pdxalz/AnnieM/(threads)

Thread 6 (2023-08-28):

Gusts and Lulls

pdxalz, 2023-08-28:
Annie should keep track of gusts and lulls along with current wind speed.

pdxalz, 2023-12-30:
Now tracks average wind gusts and lulls every minute over a 10 minute period

Closed 2023-12-30.

Thread 7 (2023-08-28):

New remote commands

pdxalz, 2023-08-28:
Remotely be able:

1. Reset
2. Request the current wind status
3. Change the MQTT broker.

Closed 2024-05-22.
