pdxalz/AnnieM/pcb/AnnieM.kicad_pcb

## KiCad design pcb/AnnieM.kicad_pcb (2023-12-28)

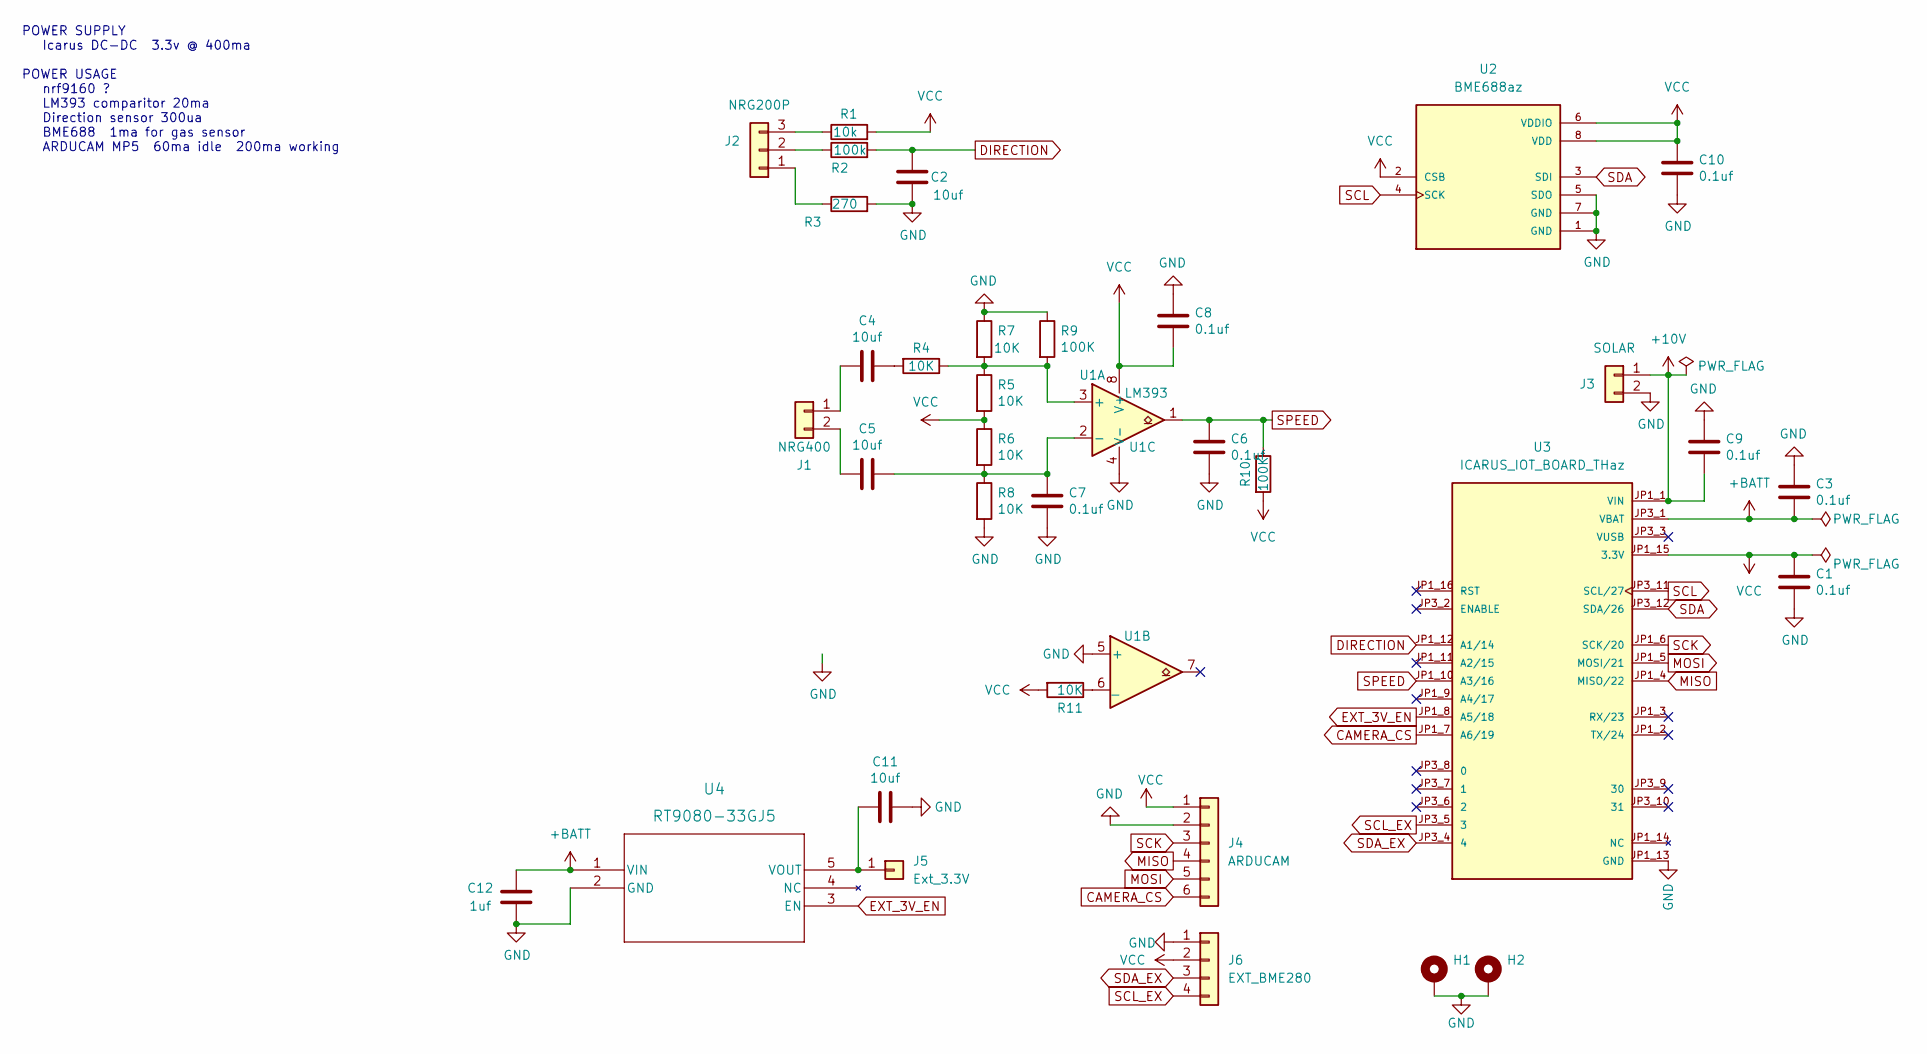
[picture p1: schematic AnnieM.kicad_sch]

Parts:
C1, C3, C6, C7, C8, C9, C10: 0.1uf; C_0603_1608Metric
C2, C4, C5, C11: 10uf; C_0805_2012Metric
C12: 1uf; C_0805_2012Metric
H1, H2: MountingHole_2.2mm_M2_DIN965_Pad
J1: NRG400; TerminalBlock_RND_205-00232_1x02_P5.08mm_Horizontal
J2: NRG200P; TerminalBlock_RND_205-00233_1x03_P5.08mm_Horizontal
J3: SOLAR; JST_XA_B02B-XASK-1_1x02_P2.50mm_Vertical
J4: ARDUCAM; PinHeader_1x06_P2.54mm_Vertical
J5: Ext_3.3V; PinSocket_1x01_P2.54mm_Vertical
J6: EXT_BME280; PinSocket_1x04_P2.54mm_Vertical
R1: 10k; R_0603_1608Metric
R2: 100k; R_0603_1608Metric
R3: 270; R_0603_1608Metric
R4, R5, R6, R7, R8, R11: 10K; R_0603_1608Metric
R9, R10: 100K; R_0603_1608Metric
U1: LM393; DIP-8_W7.62mm_LongPads
U2: BME688az; IC_BME688; PARTREV 1.0
U3: ICARUS_IOT_BOARD_THaz; MODULE_ICARUS_IOT_BOARD_THaz; PARTREV January 20, 2020
U4: RT9080-33GJ5; TSOT-23-5

Connections:
+10V: C9.1, J3.1, U3.JP1_1 (VIN)
+BATT: C3.1, C12.1, U3.JP3_1 (VBAT), U4.1 (VIN)
CAMERA_CS: J4.6, U3.JP1_7 (A6/19)
DIRECTION: C2.2, R2.2, U3.JP1_12 (A1/14)
EXT_3V_EN: U3.JP1_8 (A5/18), U4.3 (EN)
GND: C1.1, C2.1, C3.2, C6.1, C7.1, C8.2, C9.2, C10.1, C11.1, C12.2, H1.1, H2.1, J3.2, J4.2, J6.1, R3.2, R7.1, R8.2, R9.1, U1.4 (V-), U1.5 (+), U2.1 (GND), U2.5 (SDO), U2.7 (GND), U3.JP1_13 (GND), U4.2 (GND)
MISO: J4.4, U3.JP1_4 (MISO/22)
MOSI: J4.5, U3.JP1_5 (MOSI/21)
unnamed: C4.1, R4.2
unnamed: C4.2, J1.1
unnamed: C5.1, C7.2, R6.2, R8.1, U1.2 (-)
unnamed: C5.2, J1.2
unnamed: C11.2, J5.1, U4.5 (VOUT)
unnamed: J2.1, R3.1
unnamed: J2.2, R2.1
unnamed: J2.3, R1.1
unnamed: R4.1, R5.1, R7.2, R9.2, U1.3 (+)
unnamed: R11.1, U1.6 (_)
SCK: J4.3, U3.JP1_6 (SCK/20)
SCL: U2.4 (SCK), U3.JP3_11 (SCL/27)
SCL_EX: J6.4, U3.JP3_5 (3)
SDA: U2.3 (SDI), U3.JP3_12 (SDA/26)
SDA_EX: J6.3, U3.JP3_4 (4)
SPEED: C6.2, R10.1, U1.1, U3.JP1_10 (A3/16)
VCC: C1.2, C8.1, C10.2, J4.1, J6.2, R1.2, R5.2, R6.1, R10.2, R11.2, U1.8 (V+), U2.2 (CSB), U2.6 (VDDIO), U2.8 (VDD), U3.JP1_15 (3.3V)

Notes on the sheet:
POWER SUPPLY Icarus DC-DC 3.3v @ 400ma POWER USAGE nrf9160 ? LM393 comparitor 20ma Direction sensor 300ua BME688 1ma for gas sensor ARDUCAM MP5 60ma idle 200ma working

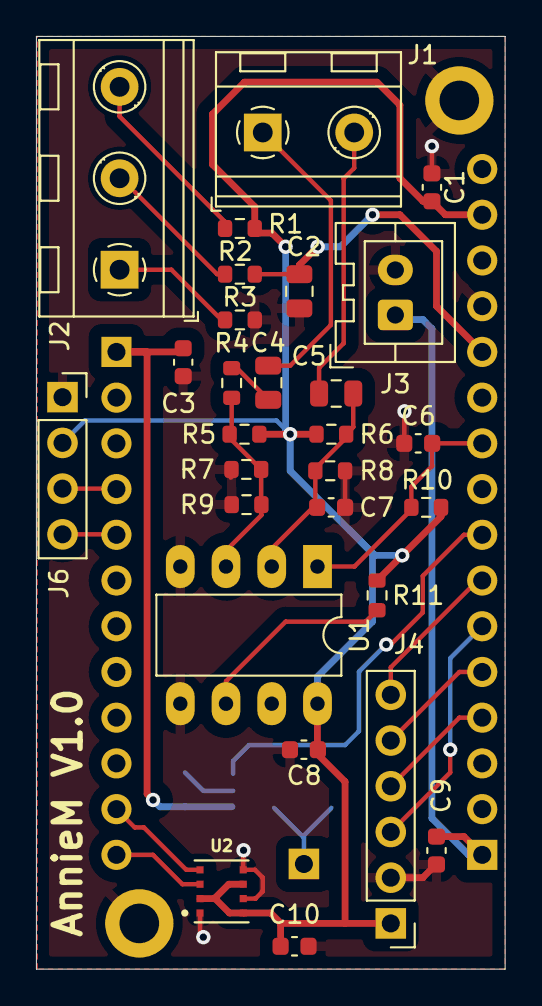
[picture p2: board AnnieM.kicad_pcb from above]

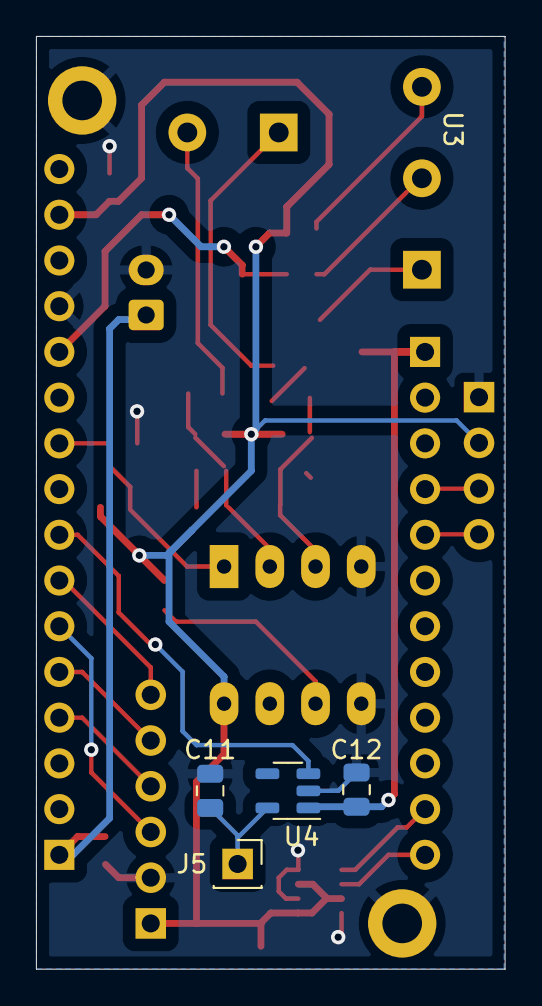
[picture p3: board AnnieM.kicad_pcb from below]

Board: 2 copper layers, 26.0 x 51.8 mm, 35 parts (5 on the bottom side), 25 nets.
