pdxalz/AnnieM/src/wind_sensor.c

#include <stdio.h>
#include <zephyr/kernel.h>
#include <zephyr/net/socket.h>
#include <modem/lte_lc.h>
#include <zephyr/drivers/gpio.h>
#include <date_time.h>

#include <zephyr/net/mqtt.h>

#include "mqtt_connection.h"
#include "wind_sensor.h"
#include "adc.h"
#include "health.h"
#include "leds.h"
#include "cameraThread.h"
#include "watchdog.h"

#include <zephyr/logging/log.h>
LOG_MODULE_REGISTER(sensor, LOG_LEVEL_INF);

#define SECONDS_PER_SAMPLE (60) // 60 is the minimum, lower requires code fix
#define SAMPLE_DURATION 6
#define REPORTS_PER_HOUR 6 // 6 is every 10 minutes
#define MINUTES_PER_REPORT (60 / REPORTS_PER_HOUR)

#define WIND_SPEED_NODE DT_ALIAS(windspeed0)
static const struct gpio_dt_spec windspeed = GPIO_DT_SPEC_GET(WIND_SPEED_NODE, gpios);

#define WIND_SCALE (102.0 / 60.0)
#define MAX_DIRECTION_VOLTAGE 1650
//#define NORTH_OFFSET 90 // Aim to the east so discontinuity is not at north
#define NORTH_OFFSET 115 // Should capture the kite beach

static volatile int frequency = 0;
static volatile int64_t lasttime = 0;

static int sample_count;
static int speed;
static int gust;
static int lull;

static uint16_t wind_direction;

// circular buffer holding direction voltages
uint16_t _dir_buf[8]; // fixed size due to averaging calculation
uint16_t _dir_idx = 0;

static struct gpio_callback windspeed_cb_data;

static void sensor_sample_timer_cb(struct k_timer *work);
static void wind_direction_timer_cb(struct k_timer *work);
static void wind_speed_sample_timer_cb(struct k_timer *work);
static void publish_reports_work_cb(struct k_work *timer_id);

static uint16_t circ_avg(uint16_t a, uint16_t b);

//************************
// Timers and Work threads
//************************
static K_TIMER_DEFINE(sensor_sample_timer, sensor_sample_timer_cb, NULL);
static K_TIMER_DEFINE(wind_direction_timer, wind_direction_timer_cb, NULL);
static K_TIMER_DEFINE(wind_speed_sample_timer, wind_speed_sample_timer_cb, NULL);
static K_WORK_DEFINE(publish_reports_work, publish_reports_work_cb);

// initiates the measuring of wind data
static void sensor_sample_timer_cb(struct k_timer *work)
{
	turn_leds_on_with_color(GREEN);

	// start counting windspeed pulses
	frequency = 0;
	k_timer_start(&wind_speed_sample_timer, K_SECONDS(SAMPLE_DURATION), K_FOREVER);

	// start sampling direction sensor
	k_timer_start(&wind_direction_timer, K_SECONDS(1), K_MSEC(400));
}

// updates the wind_direction variable by reading sensor voltage and applying a running average.
// runs multiple times while windspeed is being calculated
static void wind_direction_timer_cb(struct k_timer *work)
{
	uint16_t voltage;

	if (get_adc_voltage(ADC_WIND_DIR_ID, &voltage) != 0)
	{
		LOG_WRN("Failed to get direction voltage\n");
		return;
	};

	//	printk("direction voltage, %d\n", voltage);
	_dir_buf[_dir_idx] = (((uint32_t)voltage * 360) / MAX_DIRECTION_VOLTAGE + NORTH_OFFSET) % 360;

	_dir_idx = (_dir_idx + 1) % 8;
	wind_direction = circ_avg(
		circ_avg(circ_avg(_dir_buf[0], _dir_buf[1]), circ_avg(_dir_buf[2], _dir_buf[3])),
		circ_avg(circ_avg(_dir_buf[4], _dir_buf[5]), circ_avg(_dir_buf[6], _dir_buf[7])));

	//	LOG_INF("dir volts %d  dir %d\n", voltage, wind_direction);
}

// The timer sets the period wind speed pulses are counted. At the end of the timer
// all sensor data gathering (speed and direction) is complete and then
// the wind speed is calculated from the number of pulses counted.
// A job is submitted to send the MQTT data
static void wind_speed_sample_timer_cb(struct k_timer *work)
{
	float f = frequency / 6.0 * WIND_SCALE + 0.5;
	int current_speed = (int)f;
	++sample_count;
	speed += current_speed;
	gust = (gust > current_speed) ? gust : current_speed;
	lull = (lull < current_speed) ? lull : current_speed;

	LOG_DBG("Windspeed a=%d  g=%d  l=%d\n", current_speed, gust, lull);
	frequency = 0;

	k_work_submit(&publish_reports_work);
}

// ISR called on each pulse from the speed sensor, counts the number of pulses in
// the timer period
void windspeed_handler(const struct device *dev, struct gpio_callback *cb, uint32_t pins)
{
	int64_t time = k_uptime_get();
	// filter out sensor glitches
	if ((time - lasttime) > 10)
	{
		frequency++;
	}
	lasttime = time;
}

// background task that sends the MQTT sensor data
// data is sent less often if night time or little wind
static void publish_reports_work_cb(struct k_work *timer_id)
{
	time_t now;
	now = time(NULL);
	struct tm tm;
	gmtime_r(&now, &tm);
	int avg_speed;
	// printk("publish_reports_work_cb\n");
	int minute = tm.tm_min;

	// only report if it's the first sample period of the report period
	if (minute % MINUTES_PER_REPORT != 0)
	{
		turn_leds_on_with_color(BLUE);
		return;
	}

	turn_leds_on_with_color(MAGENTA);

	avg_speed = speed / sample_count;

	uint8_t *msgbuf = get_mqtt_message_buf();
	uint8_t *topicbuf = get_mqtt_topic_buf();

	sprintf(topicbuf, "%s/wind", CONFIG_MQTT_PRIMARY_TOPIC);
	k_timer_stop(&wind_direction_timer);

	sprintf(msgbuf, "{\"t\":\"%d/%d/%d %d:%0d\", \"d\":%d, \"a\":%d, \"g\":%d, \"l\":%d}",
			tm.tm_mon + 1, tm.tm_mday, tm.tm_year % 100, tm.tm_hour, tm.tm_min,
			wind_direction, avg_speed, gust, lull);


	// todo: necessary?  wait for photo to finish
	while (sending_photo())
	{
		turn_leds_on_with_color(WHITE);
		k_msleep(1000);
		printk("Waiting for photo to finish\n");
	}
	turn_leds_on_with_color(MAGENTA);

	int err;
	printk("Sending wind data\n");
	err = data_publish(MQTT_QOS_1_AT_LEAST_ONCE,
					   msgbuf, strlen(msgbuf), topicbuf, 0);
	printk("Wind data sent\n");
	lull = 100;
	gust = 0;
	speed = 0;
	sample_count = 0;

	if (err)
	{
		LOG_WRN("Failed to send message, %d\n", err);
		return;
	}
	watchdog_still_running();

	// update and report health data at the beginning of the hour
	printk("publishing health data. minute = %d\n", minute);
	if (minute < MINUTES_PER_REPORT)
	{
		k_msleep(1000);
		turn_leds_on_with_color(RED);
		publish_health_data();
	}
}

//************************
// Static functions
//************************

// averages two angles, result is between 0 and 359
static uint16_t circ_avg(uint16_t a, uint16_t b)
{
	int16_t diff = ((a - b + 180 + 360) % 360) - 180;
	int16_t angle = (360 + b + (diff / 2)) % 360;
	//	printk("avg=      %d, %d, %d, %d", a, b, diff, angle);
	return angle;
}

//************************
// Public functions
//************************

int init_wind_sensor()
{
	int err;
	if (!device_is_ready(windspeed.port))
	{
		return -1;
	}

	lull = 100;
	gust = 0;

	err = gpio_pin_configure_dt(&windspeed, GPIO_INPUT | GPIO_PULL_UP);
	if (err < 0)
	{
		return err;
	}
	err = gpio_pin_interrupt_configure_dt(&windspeed, GPIO_INT_EDGE_TO_ACTIVE);

	gpio_init_callback(&windspeed_cb_data, windspeed_handler, BIT(windspeed.pin));

	gpio_add_callback(windspeed.port, &windspeed_cb_data);

	k_timer_start(&sensor_sample_timer, K_SECONDS(5), K_SECONDS(SECONDS_PER_SAMPLE));

	return 0;
}
