pdxalz/AnnieM/src/adc.h

#ifndef _ADC_H_
#define _ADC_H_

// ADC Channel IDs
#define ADC_BATTERY_VOLTAGE_ID 0
#define ADC_WIND_DIR_ID 1
#define ADC_TEMPERATURE_ID 2

/**
 * @brief Take a temperature sample.
 *
 * Value will either be a real sensor value taken from a sensor with device tree alias temp_sensor,
 * (if CONFIG_TEMP_DATA_USE_SENSOR is set) or will otherwise be a pseudorandom dummy reading.
 *
 * @param[out] temp - Pointer to the double to be filled with the taken temperature sample.
 * @return int - 0 on success, otherwise, negative error code.
 */
int get_adc_voltage(uint8_t channel, uint16_t *battery_voltage);
int get_temperature();
bool init_adc();

#endif /* _ADC_H_ */
