pdxalz/AnnieM/(commit log)

2023-05-10 Initial revision. Windspeed sensor connected to GPIO-10, reporting to Log.
2023-05-11 two timers
2023-05-13 Sending speed data to mqtt broker
    [main.c, wind_sensor.c]
2023-05-20 added timer for sensor check, actual time, power ctrl
2023-05-24 cleared history at boot, cleaned msg format, added cmds, changed broker
    [main.c, mqtt_connection.c, mqtt_connection.h, wind_sensor.c]
2023-05-26 Added battery check message
2023-06-01 Added power reading
2023-06-06 Add cmd to ask for a report and 12 health samples,
2023-06-07 Added temperature module
2023-06-08 added adc code, working
2023-06-20 fixed format on json string
    [wind_sensor.c]
2023-06-22 working on power management
2023-07-06 dead sensor message
2023-07-22 Speed, Dir, & voltage working
2023-07-25 Added PCB files
    [AnnieM.kicad_pcb, AnnieM.kicad_sch, AnnieM.sch]
2023-08-01 added pull up to schematic
    [AnnieM.kicad_pcb, AnnieM.kicad_sch]
2023-08-01 Temperature adc is working, fixed adc code.
    [adc.c, adc.h, health.c, main.c, wind_sensor.c]
2023-08-14 Minor changes for power consumption
2023-08-18 graph ends at current time
2023-08-23 lager size for current wind
2023-12-08 Restarted pcb layout, added bme866 and Arducam 5MP
    [AnnieM.kicad_pcb, AnnieM.kicad_sch]
2023-12-10 Changed LED status
2023-12-13 Using Logging system, printing published data.
2023-12-14 relayout, new temp and camera connection
    [AnnieM.kicad_pcb, AnnieM.kicad_sch]
2023-12-14 Reordered annotations graphically
    [AnnieM.kicad_pcb, AnnieM.kicad_sch]
2023-12-17 Fixed time issues, removed unneeded recent message
    [health.c, mqtt_connection.c, mqtt_connection.h, wind_sensor.c]
2023-12-19 reorganized and renamed wind sensor timers and routines
2023-12-21 cleaned up buffer usage, possible buffer overflow fix
    [health.c, mqtt_connection.c, mqtt_connection.h, wind_sensor.c]
2023-12-23 changed board area to be 2"
    [AnnieM.kicad_pcb]
2023-12-28 Minor changes, Sent off to OSHPark
    [AnnieM.kicad_pcb, AnnieM.kicad_sch]
2024-01-11 Send current wind only.
2024-01-27 made data order consistant, shorten time msg, fixed avg bug
    [wind_sensor.c]
2024-02-23 Added camera code. Working out serial port.
2024-02-28 Increased stack and mem pool, attempts at fixing mem issue. Works but not reliably.
    [ArducamCamera.c, mqtt_connection.c]
2024-03-02 Camera code suddenly working great. Don't know why.
2024-03-13 Added commands for serial photo and hacks to hide corruption issues. Working ok, but large images get corrupted
    [cameraThread.c, mqtt_connection.c, wind_sensor.c]
2024-03-18 Added external power control
2024-03-19 Camera power on only for image capture.
2024-04-12 fixed health not updating issue, set reports to 6 per hour, changed watchdog to less often, fixed minor debug issue,
    [health.c, mqtt_connection.c, watchdog.c, wind_sensor.c]
2024-04-30 Changes before installing sensor (I think). Added temperature and pressure to the health status. Also tried to improve camera reliability.
2024-05-01 Added reset command z!, and added humidity to health report.
    [cameraThread.c, health.c]
2024-05-02 Move direction ADC input to A2, removed obsolete temperature adc
2024-05-02 Moved windspeed to PIO_1.2, pin JP3-6
2024-05-03 Fixed photo send bug. Still has timeout issue.
    [cameraThread.c]
2024-05-10 added commands, h-health, l-led,
2024-11-04 Added camera support code, minor camera tweaks.
2025-04-06 switched to personal mqtt broker
    [mqtt_connection.c]
